niteeshkumar17/Smart-Pumps/pcb/out/render_bottom.png

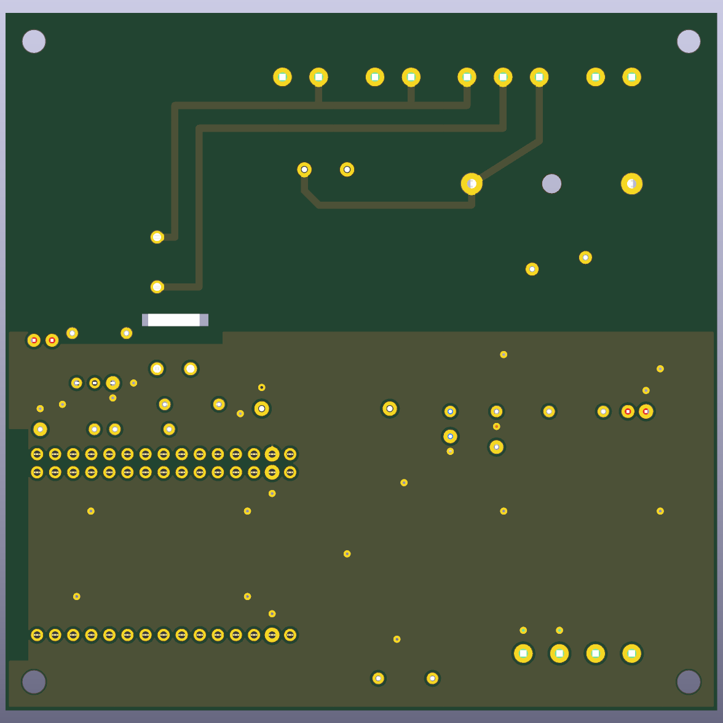
pcb/out/render_bottom.png
