niteeshkumar17/Smart-Pumps/pcb/tank_controller.kicad_pcb

## KiCad design pcb/tank_controller.kicad_pcb (2026-10-24)

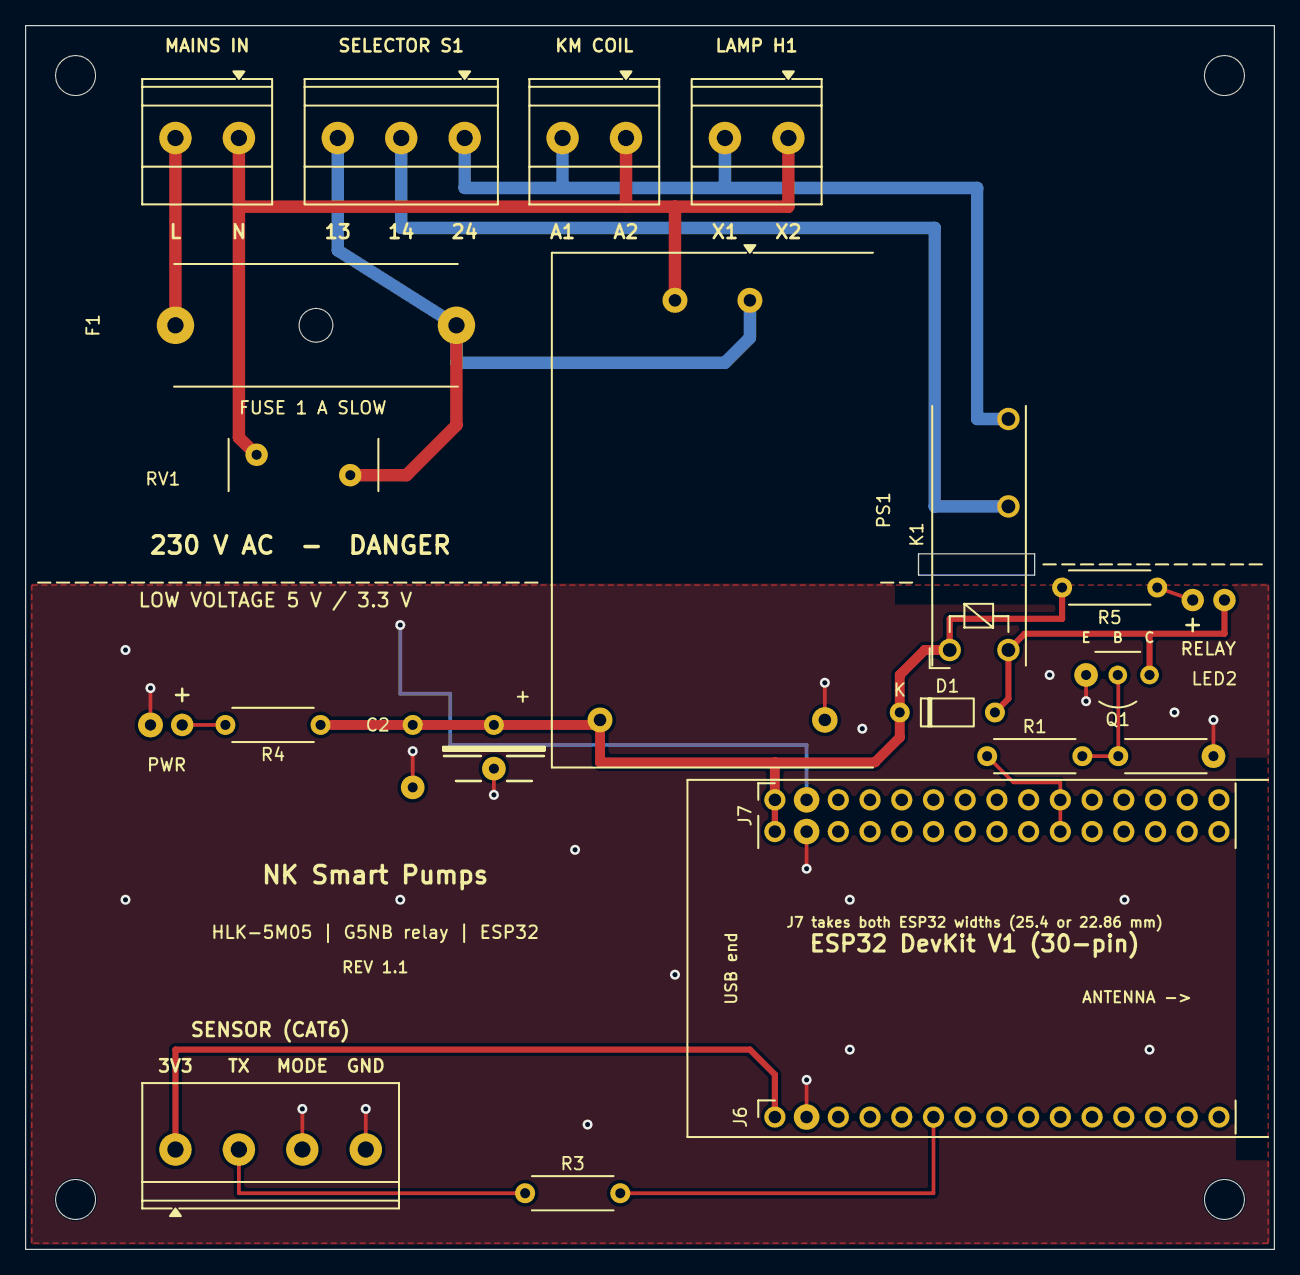
[picture p16: board tank_controller.kicad_pcb from above]

Board: 2 copper layers, 100.0 x 98.0 mm, 26 parts (0 on the bottom side), 15 nets.

Parts:
C1: 470uF 16V; CP_Radial_D8.0mm_P3.50mm
C2: 100nF; C_Disc_D5.0mm_W2.5mm_P5.00mm
D1: 1N4148; D_DO-35_SOD27_P7.62mm_Horizontal
F1: 1A T; Fuseholder_Cylinder-5x20mm_Schurter_0031_8201_Horizontal_Op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
H1, H2, H3, H4: MountingHole_3.2mm_M3
J1: MAINS IN; TerminalBlock_Phoenix_MKDS-1,5-2-5.08_1x02_P5.08mm_Horizont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
J2: SELECTOR S1; TerminalBlock_Phoenix_MKDS-1,5-3-5.08_1x03_P5.08mm_Horizont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
J3: KM COIL; TerminalBlock_Phoenix_MKDS-1,5-2-5.08_1x02_P5.08mm_Horizont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
J4: LAMP H1; TerminalBlock_Phoenix_MKDS-1,5-2-5.08_1x02_P5.08mm_Horizont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
J5: SENSOR; TerminalBlock_Phoenix_MKDS-1,5-4-5.08_1x04_P5.08mm_Horizont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
J6: ESP32 3V3 side; PinSocket_1x15_P2.54mm_Vertical
J7: ESP32 VIN side; PinSocket_2x15_P2.54mm_Vertical
K1: G5NB-1A-E 5VDC; Relay_SPST_Omron_G5NB
LED1: PWR; LED_D3.0mm
LED2: RELAY; LED_D3.0mm
PS1: HLK-5M05; Converter_ACDC_Hi-Link_HLK-5Mxx
Q1: BC547; TO-92_Inline_Wide
R1, R4, R5: 1k; R_Axial_DIN0207_L6.3mm_D2.5mm_P7.62mm_Horizontal
R2: 10k; R_Axial_DIN0207_L6.3mm_D2.5mm_P7.62mm_Horizontal
R3: 330; R_Axial_DIN0207_L6.3mm_D2.5mm_P7.62mm_Horizontal
RV1: 275VAC; RV_Disc_D12mm_W4.2mm_P7.5mm

Connections:
+3V3: J5.1, J6.1
+5V: C1.1, C2.1, D1.1, J7.1, J7.2, K1.A1, PS1.4, R4.1, R5.1
A1: J2.1, J3.2, J4.2, K1.14
AUTO: J2.2, K1.13
BASE: Q1.2, R1.2, R2.1
COIL_N: D1.2, K1.A2, LED2.1, Q1.1
GND: C1.2, C2.2, J5.3, J5.4, J6.2, J7.3, J7.4, LED1.1, PS1.3, Q1.3, R2.2
LED_PWR: LED1.2, R4.2
LED_RLY: LED2.2, R5.2
L_F: F1.2, J2.3, PS1.1, RV1.1
L_IN: F1.1, J1.2
N: J1.1, J3.1, J4.1, PS1.2, RV1.2
RLY: J7.19, J7.20, R1.1
RX2: J6.6, R3.2
SENS_TX: J5.2, R3.1
