niteeshkumar17/Smart-Pumps/pcb-mono/mono_controller.kicad_pcb

## KiCad design pcb-mono/mono_controller.kicad_pcb (2026-10-12)

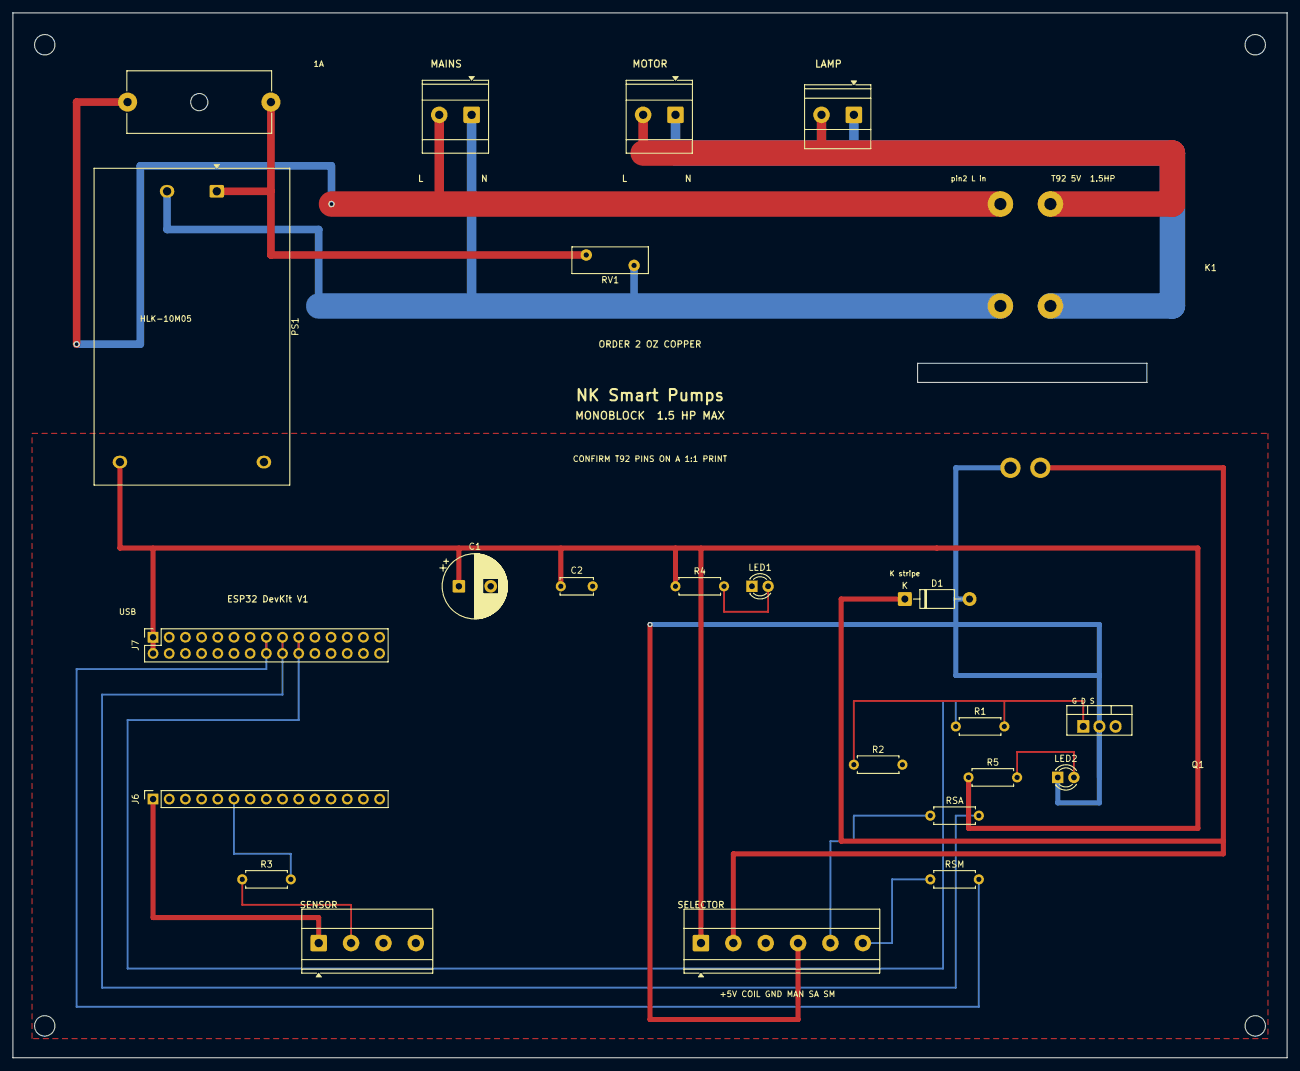
[picture p17: board mono_controller.kicad_pcb from above]

Board: 2 copper layers, 200.0 x 164.0 mm, 28 parts (0 on the bottom side), 20 nets.

Parts:
C1: 1000uF 16V; CP_Radial_D10.0mm_P5.00mm
C2: 100nF; C_Disc_D5.0mm_W2.5mm_P5.00mm
D1: 1N4007; D_DO-41_SOD81_P10.16mm_Horizontal
F1: 1A T; Fuseholder_Cylinder-5x20mm_Schurter_0031_8201_Horizontal_Op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
H1, H2, H3, H4: MountingHole_3.2mm_M3
J1: MAINS; TerminalBlock_Phoenix_MKDS-3-2-5.08_1x02_P5.08mm_Horizontal
J2: MOTOR; TerminalBlock_Phoenix_MKDS-3-2-5.08_1x02_P5.08mm_Horizontal
J3: LAMP; TerminalBlock_Phoenix_MKDS-1,5-2-5.08_1x02_P5.08mm_Horizont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
J4: SELECTOR; TerminalBlock_Phoenix_MKDS-1,5-6-5.08_1x06_P5.08mm_Horizont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
J5: SENSOR; TerminalBlock_Phoenix_MKDS-1,5-4-5.08_1x04_P5.08mm_Horizont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
J6: ESP32 3V3 side; PinSocket_1x15_P2.54mm_Vertical
J7: ESP32 VIN side; PinSocket_2x15_P2.54mm_Vertical
K1: T92P7D12-5; Relay_TE_T92
LED1: PWR; LED_D3.0mm
LED2: RELAY; LED_D3.0mm
PS1: HLK-10M05; Converter_ACDC_Hi-Link_HLK-10Mxx
Q1: IRLZ44N; TO-220-3_Vertical
R1: 100; R_Axial_DIN0207_L6.3mm_D2.5mm_P7.62mm_Horizontal
R2: 100k; R_Axial_DIN0207_L6.3mm_D2.5mm_P7.62mm_Horizontal
R3: 330; R_Axial_DIN0207_L6.3mm_D2.5mm_P7.62mm_Horizontal
R4, R5: 1k; R_Axial_DIN0207_L6.3mm_D2.5mm_P7.62mm_Horizontal
RSA: 1k; R_Axial_DIN0207_L6.3mm_D2.5mm_P7.62mm_Horizontal
RSM: 1k; R_Axial_DIN0207_L6.3mm_D2.5mm_P7.62mm_Horizontal
RV1: 275VAC; RV_Disc_D12mm_W4.2mm_P7.5mm

Connections:
+3V3: J5.1, J6.1
+5V: C1.1, C2.1, J4.1, J7.1, J7.2, PS1.4, R4.1, R5.1
COIL: D1.1, J4.2, K1.1
DRAIN: D1.2, J4.4, K1.0, LED2.1, Q1.2
GATE: Q1.1, R1.2, R2.1
GND: C1.2, C2.2, J4.3, J5.3, J5.4, J6.2, J7.3, J7.4, LED1.1, PS1.3, Q1.3, R2.2
LED_PWR: LED1.2, R4.2
LED_RLY: LED2.2, R5.2
L_F: F1.2, PS1.1, RV1.1
L_IN: F1.1, J1.2, K1.2
L_OUT: J2.2, J3.2, K1.4
N_IN: J1.1, K1.6, PS1.2, RV1.2
N_OUT: J2.1, J3.1, K1.8
RLY: J7.19, J7.20, R1.1
RX2: J6.6, R3.2
SA: J4.5, RSA.1
SEL_A: J7.17, J7.18, RSA.2
SEL_M: J7.15, J7.16, RSM.2
SENS_TX: J5.2, R3.1
SM: J4.6, RSM.1
