niteeshkumar17/Smart-Pumps/(commit log)

2026-10-12 Add the NK Smart Pumps controller, both boards, and the build guide.
    [mono_controller-B_Cu.gbl, mono_controller-B_Mask.gbs, mono_controller-B_Silkscreen.gbo, mono_controller-Edge_Cuts.gm1, mono_controller-F_Cu.gtl, mono_controller-F_Mask.gts, mono_controller-F_Silkscreen.gto, mono_controller-NPTH-drl_map.gbr]
2026-10-24 Rev 1.1: polarity marks that survive the silk clean-up, in-stock BOM parts.
    The October 2026 boards came with Q1 backwards: pull_silk() had stripped the
    TO-92 outline, leaving only a straight line. Copper is unchanged.
    [tank_controller-B_Cu.gbl, tank_controller-B_Mask.gbs, tank_controller-B_Silkscreen.gbo, tank_controller-Edge_Cuts.gm1, tank_controller-F_Cu.gtl, tank_controller-F_Mask.gts, tank_controller-F_Silkscreen.gto, tank_controller-NPTH-drl_map.gbr]
